Bashitha07/ESP32-PID-DC-Motor-Control/Photos/Circuit GenAI.jpeg

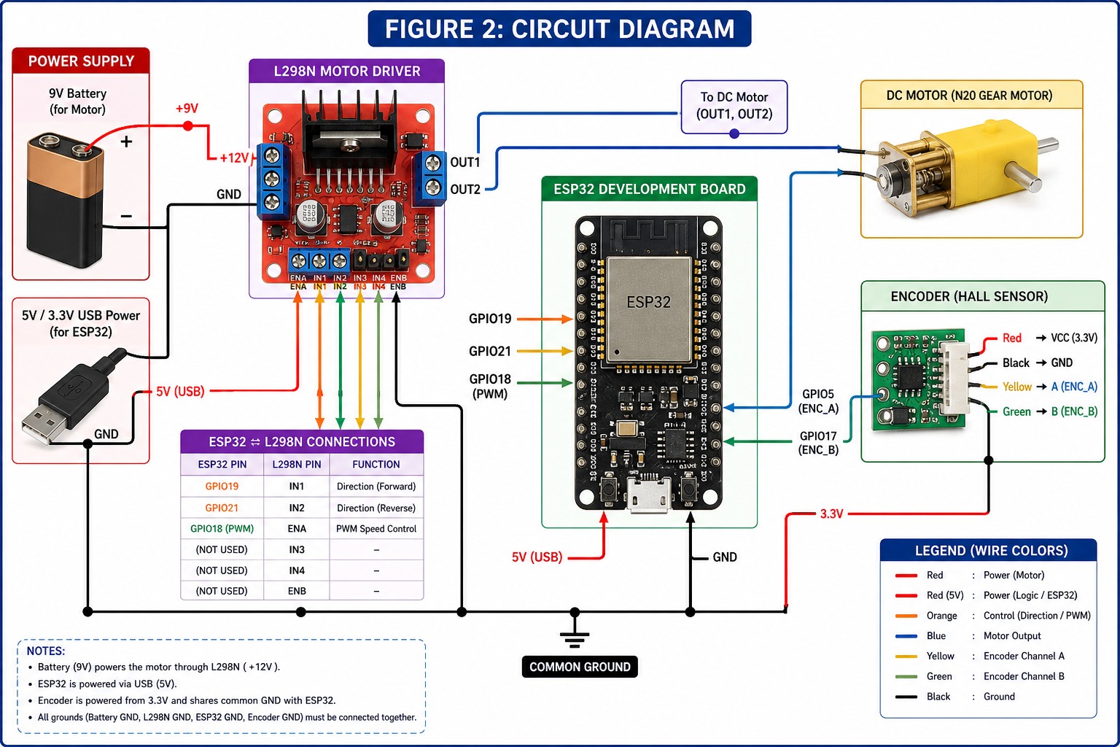
Photos/Circuit GenAI.jpeg
