Bashitha07/ESP32-PID-DC-Motor-Control/Photos/Circuit Diagram.jpeg

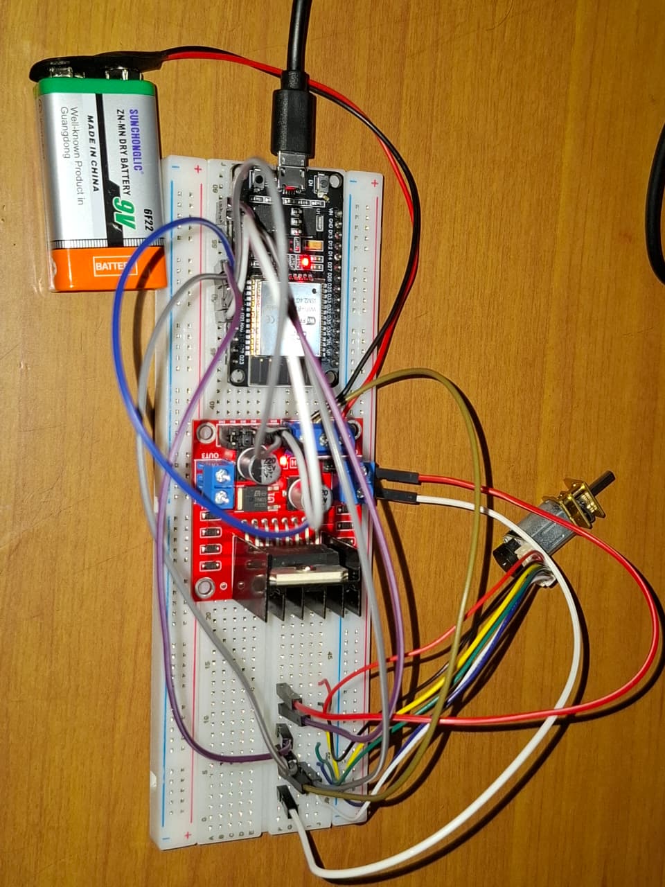
Photos/Circuit Diagram.jpeg
