Bashitha07/ESP32-PID-DC-Motor-Control/Photos/100(2).png

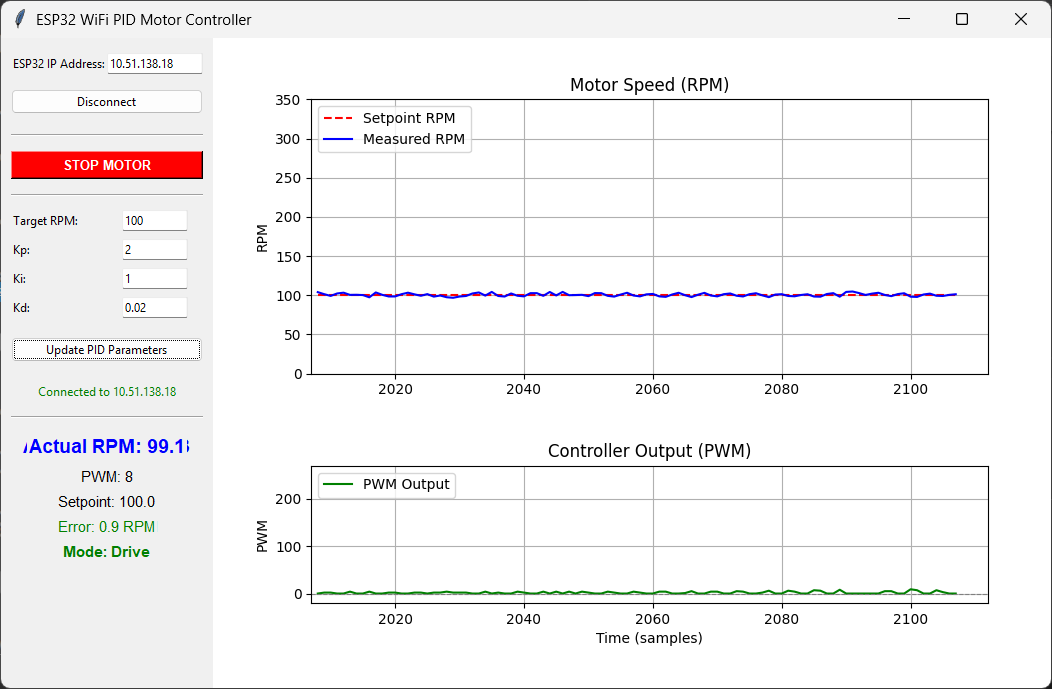
Photos/100(2).png
