Bashitha07/ESP32-PID-DC-Motor-Control/Photos/130.png

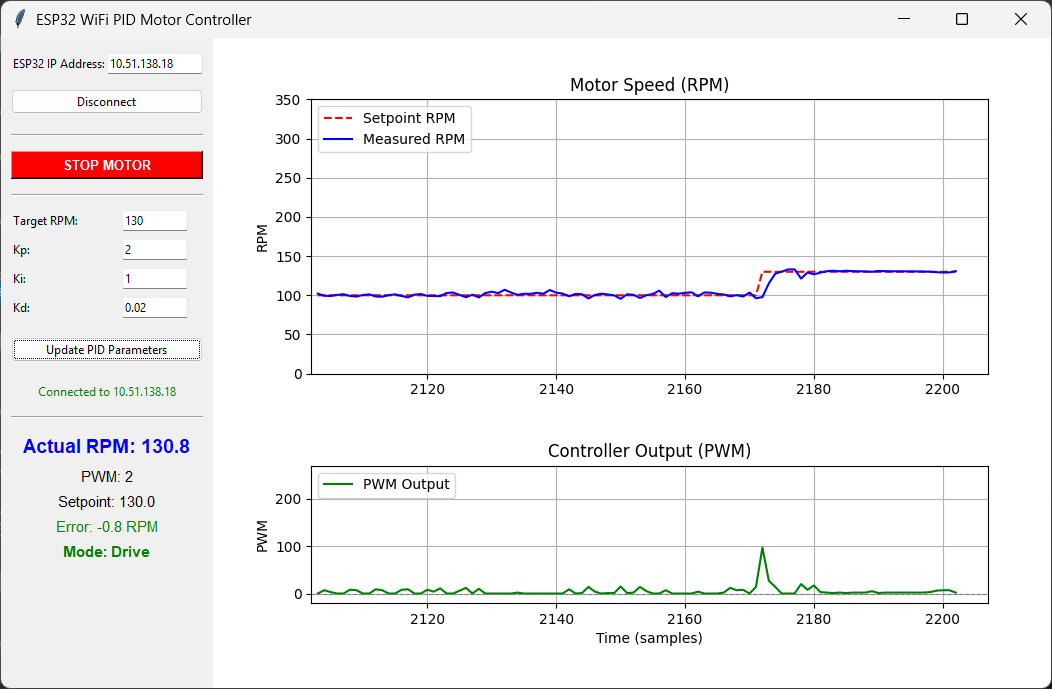
Photos/130.png
