Bashitha07/ESP32-PID-DC-Motor-Control/Photos/150.png

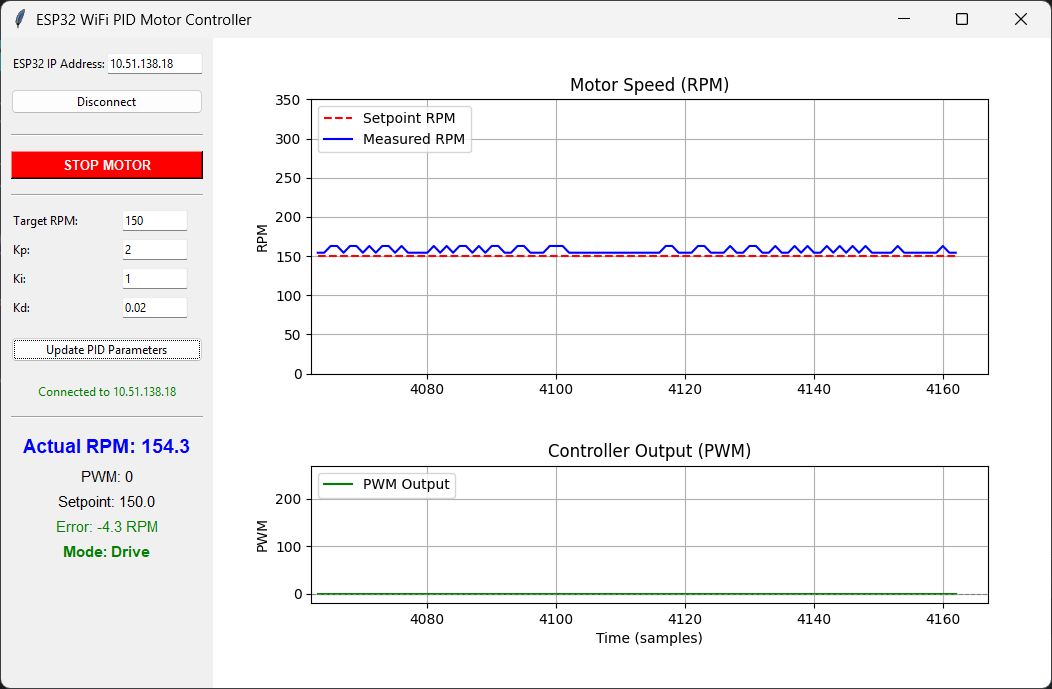
Photos/150.png
