Bashitha07/ESP32-PID-DC-Motor-Control/Photos/176.png

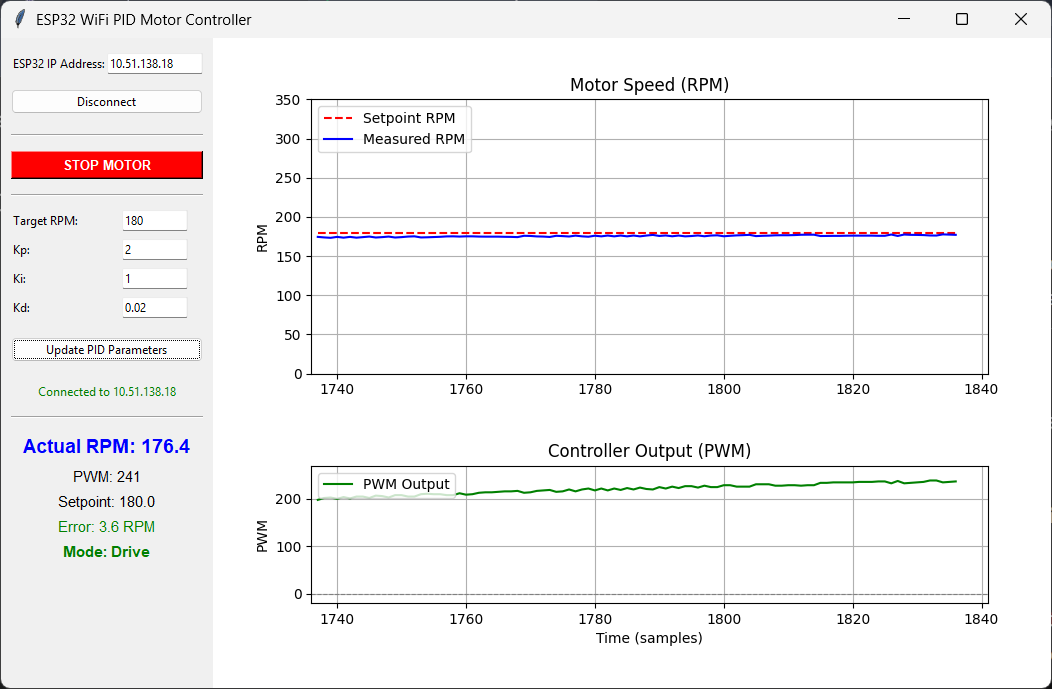
Photos/176.png
