Bashitha07/ESP32-PID-DC-Motor-Control/Photos/180(2).png

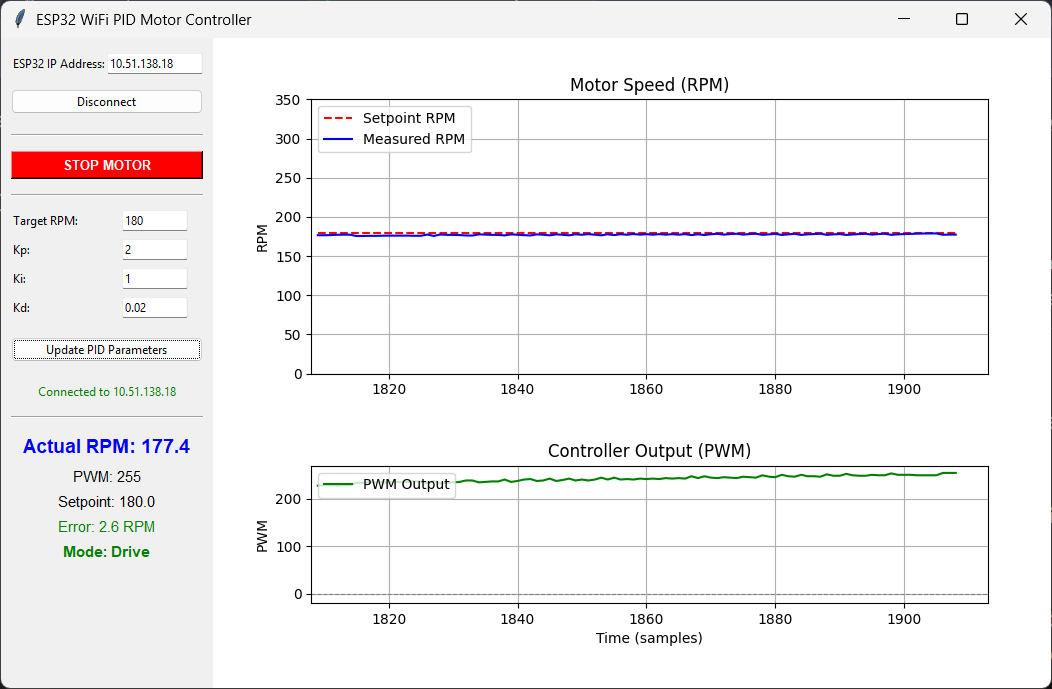
Photos/180(2).png
