Bashitha07/ESP32-PID-DC-Motor-Control/Photos/180.png

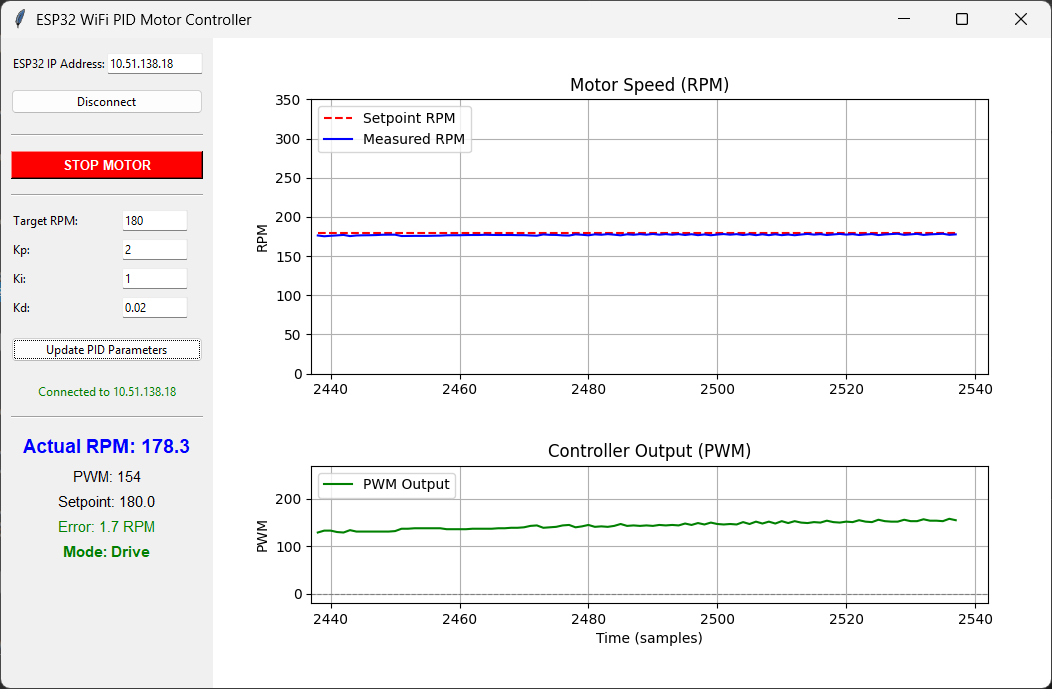
Photos/180.png
