Bashitha07/ESP32-PID-DC-Motor-Control/Photos/200.png

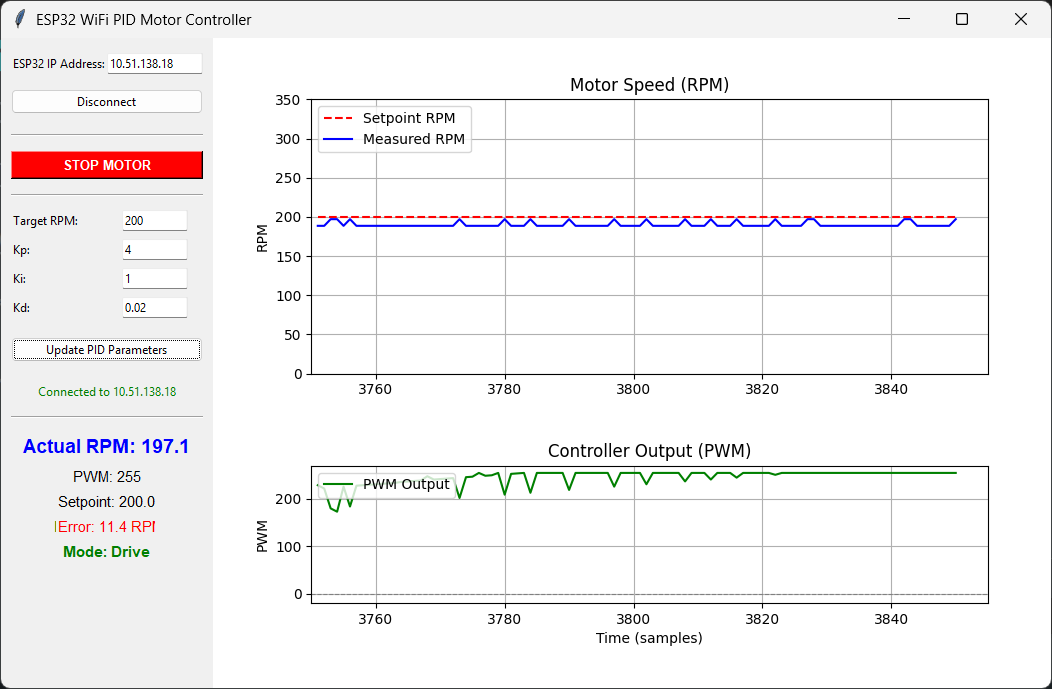
Photos/200.png
